diegovalverde/papiGB/(list of files, cad)

Other CAD files:
cad/papiGB.scad
