diegovalverde/papiGB/rtl/timers.v

`timescale 1ns / 1ps
`include "collaterals.v"
`include "z80_opcode_definitions.v"
`include "aDefinitions.v"
////////////////////////////////////////////////////////////////////////////////////
//
// pGB, yet another FPGA fully functional and super fun GB classic clone!
// Copyright (C) 2015-2016  Diego Valverde (diego.valverde.g@gmail.com)
//
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
////////////////////////////////////////////////////////////////////////////////////

`define TIMER_AFTER_RESET   0
`define TIMER_WAIT_FOR_TICK 1
`define TIMER_INC           2
`define TIMER_INC_BTAKEN    3
`define TIMER_INC_BTAKEN_NOT_EOF 4
`define TIMER_WAIT_EOF           5

`define INITIAL_STATE_INT   0
`define WAIT_FOR_INTERRUPT  1
`define INT_ACTIVATED       2
`define ENABLE_INT_OFFSET   3

`define INITIAL_STATE_TIMA  0
`define WAIT_FOR_TAC_2      1
`define TAC_2_ACTIVATED     2
`define WAIT_FOR_TAC_2_OFF  3


module timers
(
 input wire iClock,
 input wire iReset,
 input wire [7:0] iOpcode,
 input wire iEof,
 input wire iBranchTaken,
 input wire iInterrupt,

 input wire        iMcuWe,
 input wire [3:0]  iMcuRegSelect, //control register select comes from cpu
 input wire [7:0]  iMcuWriteData, //what does the cpu want to write


 output wire [7:0] oDiv,         //0xFF04
 output wire [7:0] oTima,        //0xFF05
 output wire [7:0] oModulo,      //0xFF06
 output wire [7:0] oTac,         //0xFF07




 output wire oInterrupt0x50

);


wire [7:0] wMcuRegWriteSelect;
assign wMcuRegWriteSelect = (1 << iMcuRegSelect);


////////////////////////////////////////////////
//
// Register 0xFF04:  Divider  Counts up at a fixed 16384Hz;
// reset to 0 whenever written to
//
////////////////////////////////////////////////

 UPCOUNTER_POSEDGE # (8) DIV
(
.Clock(  iClock  ),
.Reset(  iReset  ),
.Initial( 8'd211 ),
.Enable( wIncDiv ),
.Q(     oDiv     )
);


////////////////////////////////////////////////
//
// Register 0xFF05: Counter (Tima)  Counts up at the specified rate
// Triggers INT 0x50 when going 255->0
//
////////////////////////////////////////////////
wire      wIncTima;     //Set to indicate Tima is to be incremented by 1
assign    oInterrupt0x50 = ( oTima == 8'd255 && wIncTima ) ? 1'b1 : 1'b0;
wire [7:0] wTimaInitialvalue;
assign wTimaInitialvalue = (iReset) ? 8'b0 : oModulo ;


 UPCOUNTER_POSEDGE # (8) TIMA
(
.Clock(    iClock                   ),
.Reset(    iReset | oInterrupt0x50  ),
.Initial(  wTimaInitialvalue        ),
.Enable(   wIncTima                 ),
.Q(        oTima                    )
);


////////////////////////////////////////////////
//
// Register 0xFF06:  Modulo  When Tima overflows to 0,
// it's reset to start at Modulo
//
////////////////////////////////////////////////

reg [7:0] rModulo;
assign oModulo = rModulo;

////////////////////////////////////////////////
///
///  Register 0xFF07: Timer control (rTac)
//   Bits  Function  Details
//   0-1  Speed      00: 4096Hz
//                  01: 262144Hz
//                  10: 65536Hz
//                  11: 16384Hz
//   2    Running    1 to run timer, 0 to stop
//   3-7  Unused
///////////////////////////////////////////////
wire [5:0] wSpeed, wTimaFreq;


FFD_POSEDGE_SYNCRONOUS_RESET # ( 8 )FF_TAC
(
.Clock(           iClock              ),
.Reset(           iReset              ),
.Enable(iMcuWe & wMcuRegWriteSelect[7]),
.D(           iMcuWriteData           ),
.Q(               oTac                )
);

MUXFULLPARALELL_2SEL_GENERIC # ( 6 ) MUX_SPEED
 (
 .Sel( oTac[1:0] ),
 .I0(   6'd63    ), // 4096 Hz   = 262144 Hz / 64
 .I1(   6'd0     ), // 262144 Hz = 262144 Hz / 1
 .I2(   6'd3     ), // 65536 Hz  = 262144 Hz / 4
 .I3(   6'd15    ), // 16384 Hz  = 262144 Hz / 16
 .O(    wSpeed   )
 );

//Suma a una frecuencia de 262144 Hz
 UPCOUNTER_POSEDGE # (6) DIV_AUX
(
.Clock(                 iClock                     ),
.Reset(               iReset | wIncTima            ),
.Initial(                6'b0                      ),
.Enable( oTac[2] & (wIncDivAux | wIncDivAuxInHalt) ),
.Q(                   wTimaFreq                    )
);

assign wIncTima =  ((wTimaFreq == wSpeed) &
                   (wIncDivAux | wIncDivAuxInHalt)) ? 1'b1 : 1'b0;


wire wIsCb;
wire [1:0] wDivOverflow;
reg  rIsBranch;



    wire [47:0] wClockIncrementRow, wClockIncrementRowCB;
    wire [47:0] wClockIncrementRowBasic,wClockIncrementRowBranch,wClockIncrementRow_Pre, wClockIncrementRow_Pre_Pre;
    wire [2:0]  wClockIncrement;


    MUXFULLPARALELL_4SEL_GENERIC #(48) MUX_CLOCK_STEP_1
    (
        .Sel(iOpcode[7:4]),
    /*000*/    .I0( {3'd1, 3'd3, 3'd2, 3'd2, 3'd1, 3'd1, 3'd2, 3'd1, 3'd5, 3'd2, 3'd2, 3'd2, 3'd1, 3'd1, 3'd2, 3'd1}),
    /*016*/    .I1( {3'd1, 3'd3, 3'd2, 3'd2, 3'd1, 3'd1, 3'd2, 3'd1, 3'd3, 3'd2, 3'd2, 3'd2, 3'd1, 3'd1, 3'd2, 3'd1}),
    /*032*/    .I2( {3'd2, 3'd3, 3'd2, 3'd2, 3'd1, 3'd1, 3'd2, 3'd1, 3'd2, 3'd2, 3'd2, 3'd2, 3'd1, 3'd1, 3'd2, 3'd1}),
    /*048*/    .I3( {3'd2, 3'd3, 3'd2, 3'd2, 3'd3, 3'd3, 3'd3, 3'd1, 3'd2, 3'd2, 3'd2, 3'd2, 3'd1, 3'd1, 3'd2, 3'd1}),
    /*064*/    .I4( {3'd1, 3'd1, 3'd1, 3'd1, 3'd1, 3'd1, 3'd2, 3'd1, 3'd1, 3'd1, 3'd1, 3'd1, 3'd1, 3'd1, 3'd2, 3'd1}),
    /*080*/    .I5( {3'd1, 3'd1, 3'd1, 3'd1, 3'd1, 3'd1, 3'd2, 3'd1, 3'd1, 3'd1, 3'd1, 3'd1, 3'd1, 3'd1, 3'd2, 3'd1}),
    /*096*/    .I6( {3'd1, 3'd1, 3'd1, 3'd1, 3'd1, 3'd1, 3'd2, 3'd1, 3'd1, 3'd1, 3'd1, 3'd1, 3'd1, 3'd1, 3'd2, 3'd1}),
    /*112*/    .I7( {3'd2, 3'd2, 3'd2, 3'd2, 3'd2, 3'd2, 3'd1, 3'd2, 3'd1, 3'd1, 3'd1, 3'd1, 3'd1, 3'd1, 3'd2, 3'd1}),
    /*128*/    .I8( {3'd1, 3'd1, 3'd1, 3'd1, 3'd1, 3'd1, 3'd2, 3'd1, 3'd1, 3'd1, 3'd1, 3'd1, 3'd1, 3'd1, 3'd2, 3'd1}),
    /*144*/    .I9( {3'd1, 3'd1, 3'd1, 3'd1, 3'd1, 3'd1, 3'd2, 3'd1, 3'd1, 3'd1, 3'd1, 3'd1, 3'd1, 3'd1, 3'd2, 3'd1}),
    /*160*/    .I10({3'd1, 3'd1, 3'd1, 3'd1, 3'd1, 3'd1, 3'd2, 3'd1, 3'd1, 3'd1, 3'd1, 3'd1, 3'd1, 3'd1, 3'd2, 3'd1}),
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
        .I14({3'd2, 3'd2, 3'd2, 3'd2, 3'd2, 3'd2, 3'd4, 3'd2, 3'd2, 3'd2, 3'd2, 3'd2, 3'd2, 3'd2, 3'd4, 3'd2}),
        .I15({3'd2, 3'd2, 3'd2, 3'd2, 3'd2, 3'd2, 3'd4, 3'd2, 3'd2, 3'd2, 3'd2, 3'd2, 3'd2, 3'd2, 3'd4, 3'd2}),
        .O(wClockIncrementRowCB)

    );

MUXFULLPARALELL_4SEL_GENERIC #(48) MUX_CLOCK_STEP_1_BRANCHES
(
    .Sel(iOpcode[7:4]),
    .I0({3'd1, 3'd3, 3'd2, 3'd2, 3'd1, 3'd1, 3'd2, 3'd1, 3'd5, 3'd2, 3'd2, 3'd2, 3'd1, 3'd1, 3'd2, 3'd1}),
    .I1({3'd1, 3'd3, 3'd2, 3'd2, 3'd1, 3'd1, 3'd2, 3'd1, 3'd3, 3'd2, 3'd2, 3'd2, 3'd1, 3'd1, 3'd2, 3'd1}),
    .I2({3'd3, 3'd3, 3'd2, 3'd2, 3'd1, 3'd1, 3'd2, 3'd1, 3'd3, 3'd2, 3'd2, 3'd2, 3'd1, 3'd1, 3'd2, 3'd1}),
    .I3({3'd3, 3'd3, 3'd2, 3'd2, 3'd3, 3'd3, 3'd3, 3'd1, 3'd3, 3'd2, 3'd2, 3'd2, 3'd1, 3'd1, 3'd2, 3'd1}),
    .I4({3'd1, 3'd1, 3'd1, 3'd1, 3'd1, 3'd1, 3'd2, 3'd1, 3'd1, 3'd1, 3'd1, 3'd1, 3'd1, 3'd1, 3'd2, 3'd1}),
    .I5({3'd1, 3'd1, 3'd1, 3'd1, 3'd1, 3'd1, 3'd2, 3'd1, 3'd1, 3'd1, 3'd1, 3'd1, 3'd1, 3'd1, 3'd2, 3'd1}),
    .I6({3'd1, 3'd1, 3'd1, 3'd1, 3'd1, 3'd1, 3'd2, 3'd1, 3'd1, 3'd1, 3'd1, 3'd1, 3'd1, 3'd1, 3'd2, 3'd1}),
    .I7({3'd2, 3'd2, 3'd2, 3'd2, 3'd2, 3'd2, 3'd1, 3'd2, 3'd1, 3'd1, 3'd1, 3'd1, 3'd1, 3'd1, 3'd2, 3'd1}),
    .I8({3'd1, 3'd1, 3'd1, 3'd1, 3'd1, 3'd1, 3'd2, 3'd1, 3'd1, 3'd1, 3'd1, 3'd1, 3'd1, 3'd1, 3'd2, 3'd1}),
    .I9({3'd1, 3'd1, 3'd1, 3'd1, 3'd1, 3'd1, 3'd2, 3'd1, 3'd1, 3'd1, 3'd1, 3'd1, 3'd1, 3'd1, 3'd2, 3'd1}),
    .I10({3'd1, 3'd1, 3'd1, 3'd1, 3'd1, 3'd1, 3'd2, 3'd1, 3'd1, 3'd1, 3'd1, 3'd1, 3'd1, 3'd1, 3'd2, 3'd1}),
    .I11({3'd1, 3'd1, 3'd1, 3'd1, 3'd1, 3'd1, 3'd2, 3'd1, 3'd1, 3'd1, 3'd1, 3'd1, 3'd1, 3'd1, 3'd2, 3'd1}),
    .I12({3'd5, 3'd3, 3'd4, 3'd4, 3'd6, 3'd4, 3'd2, 3'd4, 3'd5, 3'd4, 3'd4, 3'd0, 3'd6, 3'd6, 3'd2, 3'd4}),
    .I13({3'd5, 3'd3, 3'd4, 3'd0, 3'd6, 3'd4, 3'd2, 3'd4, 3'd5, 3'd4, 3'd4, 3'd0, 3'd6, 3'd0, 3'd2, 3'd4}),
    .I14({3'd3, 3'd3, 3'd2, 3'd0, 3'd0, 3'd4, 3'd2, 3'd4, 3'd4, 3'd1, 3'd4, 3'd0, 3'd0, 3'd0, 3'd2, 3'd4}),
    .I15({3'd3, 3'd3, 3'd2, 3'd1, 3'd0, 3'd4, 3'd2, 3'd4, 3'd3, 3'd2, 3'd4, 3'd1, 3'd0, 3'd0, 3'd2, 3'd4}),
    .O(wClockIncrementRowBranch)

);


//---------------------------------------------------------------
// Time offset when an interrupt occurs
reg rInterruptOffset;
reg [1:0] rCurrentState_Int, rNextState_Int;

always @(posedge iClock)
begin
    if (iReset != 1)
        rCurrentState_Int <= rNextState_Int;
    else
        rCurrentState_Int <= `INITIAL_STATE_INT;
end
//------------------------------------------------

always @( * )
begin
    case (rCurrentState_Int)
    //--------------------------
    `INITIAL_STATE_INT:
    begin
        rInterruptOffset  = 1'b0;

        rNextState_Int    = `WAIT_FOR_INTERRUPT;
    end
    //-------------------------------
    `WAIT_FOR_INTERRUPT:
    begin
        rInterruptOffset  = 1'b0;

        if (iInterrupt)
            rNextState_Int = `INT_ACTIVATED;
        else
            rNextState_Int = `WAIT_FOR_INTERRUPT;
    end
    //--------------------------------
    `INT_ACTIVATED:
    begin
        rInterruptOffset = 1'b0;

        if (~iInterrupt)
            rNextState_Int = `ENABLE_INT_OFFSET;
        else
            rNextState_Int = `INT_ACTIVATED;
    end
    //--------------------------------
    `ENABLE_INT_OFFSET:
    begin
        rInterruptOffset = 1'b1;

        if (rIncTimer | wIncDivInHalt)
            rNextState_Int = `WAIT_FOR_INTERRUPT;
        else
            rNextState_Int = `ENABLE_INT_OFFSET;
    end
    //---------------------------------
    default:
    begin
        rInterruptOffset = 1'b0;

        rNextState_Int = `WAIT_FOR_INTERRUPT;
    end
    //--------------------------------------------------
    endcase
end //always


//---------------------------------------------------------------
// Reset wDivAux when oTac[2] gets up
reg rResetDivAux;
reg [1:0] rCurrentState_TIMA, rNextState_TIMA;

always @(posedge iClock)
begin
    if (iReset != 1)
        rCurrentState_TIMA <= rNextState_TIMA;
    else
        rCurrentState_TIMA <= `INITIAL_STATE_TIMA;
end
//------------------------------------------------

always @( * )
begin
    case (rCurrentState_TIMA)
    //--------------------------
    `INITIAL_STATE_TIMA:
    begin
        rResetDivAux    = 1'b0;

        rNextState_TIMA = `WAIT_FOR_TAC_2;
    end
    //-------------------------------
    `WAIT_FOR_TAC_2:
    begin
        rResetDivAux    = 1'b0;

        if (oTac[2])
            rNextState_TIMA = `TAC_2_ACTIVATED;
        else
            rNextState_TIMA = `WAIT_FOR_TAC_2;
    end
    //--------------------------------
    `TAC_2_ACTIVATED:
    begin
        rResetDivAux    = 1'b1;

        rNextState_TIMA = `WAIT_FOR_TAC_2_OFF;
    end
    //--------------------------------
    `WAIT_FOR_TAC_2_OFF:
    begin
        rResetDivAux    = 1'b0;

        if (~oTac[2])
            rNextState_TIMA = `WAIT_FOR_TAC_2;
        else
            rNextState_Int = `WAIT_FOR_TAC_2_OFF;
    end
    //---------------------------------
    default:
    begin
        rResetDivAux    = 1'b0;

        rNextState_TIMA = `WAIT_FOR_TAC_2;
    end
    //--------------------------------------------------
    endcase
end //always


wire  [7:0] wDelta;
assign wDelta = (rInterruptOffset) ? wClockIncrement + 8'd5 : wClockIncrement;

wire [7:0] wDiv,wTima;
assign wTima = oTima;

wire [3:0] wDivAux;
wire [1:0] wDivAuxOF;
reg rTimerSel, rIncTimer;

assign {wDivOverflow,wDiv} = (rMTime << 2);
assign {wDivAuxOF,wDivAux} = (rResetDivAux) ? 6'b0 : (rMTime[3:0] << 2);

  reg  [7:0]  rMTime;
  reg         rIncrementBTime;

   always @ (posedge iClock)
   begin
      if (iReset)
      begin
        rMTime    = 8'b0;
      end
      else
      begin
        if (rIncTimer | wIncDivInHalt)
          {rIncrementBTime,rMTime} = rMTime + {4'b0,wDelta[3:0]};
      end
   end //always


   //--------------------------------------------------------
   // Current State Logic //
   reg [7:0]    rCurrentState,rNextState;

   always @(posedge iClock )
   begin
        if( iReset!=1 )
           rCurrentState <= rNextState;
      else
           rCurrentState <= `TIMER_AFTER_RESET;
   end
   //--------------------------------------------------------

   always @( * )
    begin
     case (rCurrentState)
     //----------------------------------------
     `TIMER_AFTER_RESET:
     begin
       rTimerSel    = 1'b0;
       rIncTimer    = 1'b0;

       rNextState = `TIMER_WAIT_FOR_TICK;
     end
     //----------------------------------------
     `TIMER_WAIT_FOR_TICK:
     begin
     rTimerSel    = 1'b0;
     rIncTimer    = 1'b0;

      if ( iInterrupt )
          rNextState = `TIMER_INC_BTAKEN;
      else if (rIsBranch & iBranchTaken & iEof)
          rNextState = `TIMER_INC_BTAKEN;
      else if (rIsBranch & iBranchTaken & ~iEof)
          rNextState = `TIMER_INC_BTAKEN_NOT_EOF;
      else if (iEof)
          rNextState = `TIMER_INC;
      else
          rNextState = `TIMER_WAIT_FOR_TICK;
     end
     //----------------------------------------
     `TIMER_INC:
     begin
        rTimerSel   = 1'b0;
        rIncTimer   = 1'b1;

       rNextState = `TIMER_WAIT_FOR_TICK;
     end
     //----------------------------------------
     `TIMER_INC_BTAKEN:
     begin
        rTimerSel   = 1'b1;
        rIncTimer   = 1'b1;

      if (~iInterrupt)
        rNextState = `TIMER_WAIT_FOR_TICK;
      else
        rNextState = `TIMER_WAIT_EOF;
     end
     //----------------------------------------
   `TIMER_INC_BTAKEN_NOT_EOF:
     begin
        rTimerSel   = 1'b1;
        rIncTimer   = 1'b1;
        if (iEof)
          rNextState = `TIMER_WAIT_FOR_TICK;
        else
          rNextState = `TIMER_WAIT_EOF;

     end
     //----------------------------------------
     `TIMER_WAIT_EOF:
     begin
        rTimerSel   = 1'b1;
        rIncTimer   = 1'b0;

        if (iEof)
            rNextState = `TIMER_WAIT_FOR_TICK;
        else
            rNextState = `TIMER_WAIT_EOF;
     end
     //----------------------------------------
     default:
     begin
         rTimerSel    = 1'b0;
         rIncTimer    = 1'b0;

         rNextState = `TIMER_AFTER_RESET;
     end
     //----------------------------------------
     endcase
  end //always


//--------------------------------------------------------
// Clock Increment Logic for wDIV overflow and wDivAux overflow//
reg  [8:0] rDivNextToOverflow;
reg  [5:0] rDivAuxNextToOF;
wire [5:0] wPreviousValue;
wire [8:0] wDivAuxCounter;
wire [4:0] wDivCounter;
wire wIncDiv, wIncDivAux, wDivAuxChanged, wIncDivInHalt, wIncDivAuxInHalt;


assign wIncDiv          = rDivNextToOverflow[8] & (rIncTimer | wIncDivInHalt);
assign wDivAuxChanged   = (wPreviousValue == rDivAuxNextToOF) ? 1'b0 : 1'b1;
assign wIncDivAux = wDivAuxChanged & (rDivAuxNextToOF[5] | rDivAuxNextToOF[4]);
assign wIncDivInHalt    = (wDivCounter == 5'd23) ? 1'b1 : 1'b0;
assign wIncDivAuxInHalt = (wDivAuxCounter == 9'd380) ? 1'b1 : 1'b0;


FFD_POSEDGE_SYNCRONOUS_RESET # ( 6 )FF_DIV_AUX
(
.Clock(   iClock    ),
.Reset(   iReset    ),
.Enable( rIncTimer  ),
.D( rDivAuxNextToOF ),
.Q( wPreviousValue  )
);

UPCOUNTER_POSEDGE # (9) DIV_AUX_IN_HALT
(
.Clock(         iClock            ),
.Reset( iReset | wIncDivAuxInHalt ),
.Initial(         9'b0            ),
.Enable(    iOpcode == 8'h76      ),
.Q(       wDivAuxCounter          )
);

UPCOUNTER_POSEDGE # (5) DIV_IN_HALT
(
.Clock(        iClock          ),
.Reset( iReset | wIncDivInHalt ),
.Initial(        5'b0          ),
.Enable(   iOpcode == 8'h76    ),
.Q(          wDivCounter       )
);


//-----------------------------------------------------------
always @(negedge iClock)
begin
    if (rIncTimer | wIncDivInHalt)
    begin
        rDivNextToOverflow = wDiv + (wClockIncrement << 2);
        rDivAuxNextToOF    = wDivAux + (wClockIncrement << 2);
    end
end


endmodule
