diegovalverde/papiGB/rtl/mmu.v

`timescale 1ns / 1ps
////////////////////////////////////////////////////////////////////////////////////
//
// pGB, yet another FPGA fully functional and super fun GB classic clone!
// Copyright (C) 2015-2016  Diego Valverde (diego.valverde.g@gmail.com)
//
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
////////////////////////////////////////////////////////////////////////////////////
module mmu
(
	input wire iClock,
	input wire iReset,

	//CPU
	input wire        iCpuReadRequest,
	input wire [15:0] iCpuAddr,
	input wire        iCpuWe,
	input wire [7:0]  iCpuData,
	output wire [7:0] oCpuData,

	//GPU
	output wire [7:0] oGpuVmemReadData,
	input wire        iGpuReadRequest,
	input wire [15:0] iGpuAddr,

	//Special Function Registers in other modules
	output wire [3:0] oRegSelect,
	output wire [2:0] oRegWe,
	output wire [7:0] oRegData,

	//Interrupts
	input wire [7:0] iInterruptRequest,

	//IO Registers
	input wire [7:0]  iGPU_LCDC,
	input wire [7:0]  iGPU_STAT,
	input wire [7:0]  iGPU_SCY,
	input wire [7:0]  iGPU_SCX,
	input wire [7:0]  iGPU_LY,
	input wire [7:0]  iGPU_LYC,
	input wire [7:0]  iGPU_DMA,
	input wire [7:0]  iGPU_BGP,
	input wire [7:0]  iGPU_OBP0,
	input wire [7:0]  iGPU_OBP1,
	input wire [7:0]  iGPU_WY,
	input wire [7:0]  iGPU_WX,

	input wire [7:0]  iInterruptEnable,
	input wire [7:0]  iInterruptFlag,

	//IO
	input wire [7:0] iButtonRegister


);
	wire [7:0] wBiosData, wZeroPageDataOut, wWorkRamDataOut, wZIOData, wIORegisters,wLCDRegisters,wSoundRegisters_Group0,wSoundRegisters_Group1;
	wire [7:0] wSoundRegisters_WavePattern, wJoyPadAndTimers;
	wire [15:0] wAddr, wVmemReadAddr;
	wire wInBios, wInCartridgeBank0, wWeZeroPage, wWeVRam, wCPU_GPU_Sel, wWeWorkRam;
	wire [3:0] wMemSel_H, wMemSel_L;
	wire [7:0] wReadCartridgeBank0, wReadVmem, wReadData_L, wOAMData;


	//Choose who has Memory access at this point in time: GPU or CPU
	//Simply check MSb from STAT mode. Also check to see if LCD is ON
	assign wCPU_GPU_Sel = ( iGPU_LCDC[7] & iGPU_STAT[1]  ) ? 1'b1 : 1'b0 ;
	assign wAddr =  iCpuAddr;
	assign wVmemReadAddr = ( wCPU_GPU_Sel ) ? iGpuAddr[12:0] : iCpuAddr[12:0];
	assign oRegData = iCpuData;
  assign oGpuVmemReadData = (iGpuAddr[15:8] == 8'hfe) ?  wOAMData : wReadVmem;



  ///////////////////////////////////////////////////////////////
	//
	// The MMU is essentially a cascade of Multiplexers
	// MUX_MEMREAD_H is the final Multiplexer to output the
	// oCpuData port
  //
	// Address Range: 0000 - FFFF
	//
	///////////////////////////////////////////////////////////////

	MUXFULLPARALELL_4SEL_GENERIC # (8) MUX_MEMREAD_H
	(
		.Sel( wAddr[15:12] ),
		//0000 - 7FFF : ROM Bank 0
		.I0(wReadCartridgeBank0), .I1(wReadCartridgeBank0),
		.I2(wReadCartridgeBank0), .I3(wReadCartridgeBank0),
		.I4(wReadCartridgeBank0), .I5(wReadCartridgeBank0),
		.I6(wReadCartridgeBank0), .I7(wReadCartridgeBank0),

		//8000 - 9FFF: VIDEO RAM
		.I8(wReadVmem), .I9(wReadVmem),

		//A000 - BFFF: External RAM
		.I10(8'b0), .I11(8'b0),      //A000 - BFFF

		//C000 - EFFF:  Work RAM and Echo
		.I12( wWorkRamDataOut     ), //C000 - CFFF
		.I13( wWorkRamDataOut     ), //D000 - DFFF
		.I14(wReadCartridgeBank0  ), //E000 - EFFF

		//F000 - FFFF: Extended Regions
		.I15( wReadData_L ),

		.O( oCpuData )
	);

	///////////////////////////////////////////////////////////////
	//
	// MUX: MUX_MEMREAD_L Contains extended regions
	//
	// Address Range: F000 - FFFF
	//
	///////////////////////////////////////////////////////////////


	MUXFULLPARALELL_4SEL_GENERIC # (8) MUX_MEMREAD_L
	(
		.Sel( wAddr[11:8] ),
		//ECHO
		.I0(8'b0), .I1(8'b0),   //F000 - F1FF
		.I2(8'b0), .I3(8'b0),   //F200 - F3FF
		.I4(8'b0), .I5(8'b0),   //F400 - F5FF
		.I6(8'b0), .I7(8'b0),   //F600 - F7FF
		.I8(8'b0), .I9(8'b0),   //F800 - F9FF
		.I10(8'b0), .I11(8'b0), //FA00 - FBFF
		.I12(8'b0), .I13(8'b0), //FC00 - FDFF
		//OAM.
		.I14( wOAMData),		    //FE00 - FEFF

		//Zeropage RAM, I/O, interrupts
		.I15( wZIOData ), //FF00 - FFFF

		.O( wReadData_L )
	);


	///////////////////////////////////////////////////////////////
	//
	// MUX: ZEROPAGE, INTERRUPTS, IO DATA
	//
	// Address Range: FF00 - FFFF
	//
	///////////////////////////////////////////////////////////////
	wire [7:0] wHighMemory;

	MUXFULLPARALELL_2SEL_GENERIC # (8) MUX_MEMREAD_IO_ZERPAGE_INTERRUPTS
	(
		.Sel( wAddr[7:6]),
		.I0( wIORegisters     ),    //FF00-FF3F
		.I1( wIORegisters     ),    //FF40-FF7F
		.I2( wZeroPageDataOut ),	  //FF80-FFBF
		.I3( wHighMemory      ),	  //FFC0-FFFF
		.O(  wZIOData )

	);

  assign wHighMemory =
	( wAddr == 16'hffff ) ? iInterruptEnable : wZeroPageDataOut;

	///////////////////////////////////////////////////////////////
	//
	// MUX: INTERRUPTS, IO DATA
	//
	// Address Range: FF00 - FF7F
	//
	///////////////////////////////////////////////////////////////
	MUXFULLPARALELL_3SEL_GENERIC # (8) MUX_MEMREAD_IO_REGISTERS
	(
		.Sel( wAddr[6:4]),
		.I0( wJoyPadAndTimers            ),   //FF00-FF0     wAddr[6:4] = 000
		.I1( wSoundRegisters_Group0      ),   //1F-F    wAddr[6:4] = 001
		.I2( wSoundRegisters_Group1      ),   //2F-20   wAddr[6:4] = 010
		.I3( wSoundRegisters_WavePattern ),   //3F-30   wAddr[6:4] = 011
		.I4( wLCDRegisters               ),   //4F-40   wAddr[6:4] = 100
		.I5( 8'b0                        ),
		.I6( 8'b0                        ),
		.I7( 8'b0                        ),
		.O( wIORegisters )
	);



////////////////////////////////////////////////
//
// 8000-9FFF   8KB Video RAM (VRAM) (switchable bank 0-1 in CGB Mode)
//
////////////////////////////////////////////////
RAM_SINGLE_READ_PORT # ( .DATA_WIDTH(8), .ADDR_WIDTH(13), .MEM_SIZE(8192) ) VMEM
(
 .Clock( iClock ),
 .iWriteEnable(  wWeVRam              ),
 .iReadAddress0( wVmemReadAddr[12:0]  ),
 .iWriteAddress( wAddr[12:0]          ),
 .iDataIn(       iCpuData             ),
 .oDataOut0(     wReadVmem            )
);

////////////////////////////////////////////////
//
// Sprite OAM RAM 0xFE00 - 0xFE9F
//
////////////////////////////////////////////////
RAM_SINGLE_READ_PORT # ( .DATA_WIDTH(8), .ADDR_WIDTH(8), .MEM_SIZE(160) ) OAM
(
 .Clock( iClock ),
 .iWriteEnable(  wWeVRam              ),		//Since this is DMA, this has to change
 .iReadAddress0( wVmemReadAddr[7:0]   ),
 .iWriteAddress( wAddr[7:0]           ),
 .iDataIn(       iCpuData             ),
 .oDataOut0(     wOAMData             )
);

////////////////////////////////////////////////
//
// ZERO PAGE
//
// A high-speed area of 128 bytes of RAM.
// Will use FPGA internal mem since most of the interaction between
// the program and the GameBoy hardware occurs through use of this page of memory.
//
////////////////////////////////////////////////
RAM_SINGLE_READ_PORT # ( .DATA_WIDTH(8), .ADDR_WIDTH(7), .MEM_SIZE(128) ) ZERO_PAGE
(
 .Clock( iClock ),
 .iWriteEnable( wWeZeroPage   ),
 .iReadAddress0( wAddr[6:0]   ),
 .iWriteAddress( wAddr[6:0]   ),
 .iDataIn(       iCpuData        ),
 .oDataOut0( wZeroPageDataOut )
);


////////////////////////////////////////////////
//
// Register 0xFF50: Unmaps BIOS ROM
//
////////////////////////////////////////////////

wire wWe0x50Reg;
wire [7:0] wRegMapBootStapRom;
assign wWe0x50Reg = (iCpuWe && iCpuAddr == 4'hff50) ? 1'b1: 1'b0;
FFD_POSEDGE_SYNCRONOUS_RESET # ( 8 )FF_0x50(
	iClock, iReset  , wWe0x50Reg, iCpuData, wRegMapBootStapRom );



RAM_SINGLE_READ_PORT # ( .DATA_WIDTH(8), .ADDR_WIDTH(13), .MEM_SIZE(8191) ) WORK_RAM
(
 .Clock( iClock ),
 .iWriteEnable( wWeWorkRam   ),
 .iReadAddress0( wAddr[12:0]   ),
 .iWriteAddress( wAddr[12:0]   ),
 .iDataIn(       iCpuData        ),
 .oDataOut0( wWorkRamDataOut )
);

//both addresses FFFF and FF0F yield to interrupts, this is why we
//remap FFFF to 0000
assign oRegSelect = ( &iCpuAddr ) ? 4'b0 : wAddr[3:0];

///  READ .///

`ifdef LY_OVERRIDE_PATH
wire [7:0] wGPU_LY;

ly_override lyover((iCpuReadRequest == 1'b1 && wAddr == 16'hff44) ,wGPU_LY);

`endif
MUXFULLPARALELL_4SEL_GENERIC # (8) MUX_MEMREAD_LCD_REGISTERS
(
	.Sel( wAddr[3:0]),
	.I0( iGPU_LCDC            ),
	.I1( iGPU_STAT            ),
	.I2( iGPU_SCY             ),
	.I3( iGPU_SCX             ),
`ifdef LY_OVERRIDE_PATH
	.I4( wGPU_LY              ),
`else
	.I4( iGPU_LY              ),
`endif
	.I5( iGPU_LYC             ),
	.I6( iGPU_DMA             ),
	.I7( iGPU_BGP             ),
	.I8( iGPU_OBP0            ),
	.I9( iGPU_OBP1            ),
	.I10( iGPU_WY             ),
	.I11( iGPU_WX             ),
	.I12( 8'b0                ),
	.I13( 8'b0                ),
	.I14( 8'b0                ),
	.I15( 8'b0                ),
	.O( wLCDRegisters )
);





MUXFULLPARALELL_4SEL_GENERIC # (8) MUX_MEMREAD_IO_BUTTON
(
	.Sel( wAddr[3:0]),
	.I0( iButtonRegister            ),   //FF00 P1 register
	.I1(8'b0  ), //FF01
	.I2(8'b0  ), //FF02
	.I3(8'b0  ), //FF03
	.I4(8'b0  ), //FF04
	.I5(8'b0  ), //FF05
	.I6(8'b0  ), //FF06
	.I7(8'b0  ), //FF07
	.I8(8'b0  ), //FF08
	.I9(8'b0  ), //FF09
	.I10(8'b0  ), //FF0A
 	.I11(8'b0  ), //FF0B
	.I12(8'b0  ), //FF0C
	.I13(8'b0  ), //FF0D
	.I14(8'b0  ), //FF0E
	.I15(iInterruptFlag  ), //FF0F
	.O( wJoyPadAndTimers  )
);




	bios BIOS
	(
		.iClock( iClock ),
		.iAddr( iCpuAddr[7:0] ),
		.oData( wBiosData  )
	);

//ZeroPage FF80 - FFFF
assign wWeZeroPage = ( iCpuWe && wAddr[15:12] == 4'hf && wAddr[11:8] == 4'hf && (wAddr[7:6] == 2'h2 || wAddr[7:6] == 2'h3) ) ? 1'b1 : 1'b0 ;
assign wWeVRam     = ( iCpuWe && (wAddr[15:12] == 4'h8 || wAddr[15:12] == 4'h9 ) ) ? 1'b1 : 1'b0;
assign oRegWe[0]  = ( iCpuWe && wAddr[15:4] == 12'hff4 ) ? 1'b1 : 1'b0;  //GPU
assign oRegWe[1]  = ( iCpuWe && wAddr[15:4] == 12'hff0 ) ? 1'b1 : 1'b0;  //TIMER
assign oRegWe[2]  = ( iCpuWe & (&wAddr | wAddr == 16'hff0f) ) ? 1'b1 : 1'b0;  //INTERRUPT
//Working RAM C000 - DFFF
assign wWeWorkRam  = ( iCpuWe && wAddr[15:13] == 3'h6 ) ? 1'b1 : 1'b0;


assign wInBios           = (wAddr & 16'hff00) ? 1'b0 : 1'b1; //0x000 - 0x0100, also remember to use 0xff50, this unmaps bios ROM
assign wInCartridgeBank0 = (wAddr & 16'hc000) ? 1'b0 : 1'b1; //0x100 - 0x3fff

`ifndef REAL_CARTRIDGE_DATA
wire [7:0] wCartridgeDataBank0;

assign wReadCartridgeBank0 = (wInBios & ~wRegMapBootStapRom[0] ) ? wBiosData : wCartridgeDataBank0;



dummy_cartridge DummyCartridgeBank0
(
  .iAddr( wAddr ),
	.oData( wCartridgeDataBank0 )
);

`endif
endmodule
`ifndef REAL_CARTRIDGE_DATA

`ifdef CARTRIGDE_DUMP_PATH
module dummy_cartridge
(
  input wire [15:0] iAddr,
	output reg [7:0] oData
);

reg [7:0] mem[65534:0];

always @ (iAddr)
begin
	 #(2*`CLOCK_CYCLE) oData = mem[iAddr];
end

initial
begin
	$readmemh(
		`CARTRIGDE_DUMP_PATH, mem);

end

endmodule

`else
module dummy_cartridge
(
  input wire [15:0] iAddr,
	output reg [7:0] oData
);

always @ ( iAddr )
begin
	case ( iAddr )
	//Add dummy game cartrige header
	16'h100: oData = 8'h00;
	16'h101: oData = 8'hc3;
	16'h102: oData = 8'h50;
	16'h103: oData = 8'h01;
	16'h104: oData = 8'hce; //Start of LOGO
	16'h105: oData = 8'hed;
	16'h106: oData = 8'h66;
	16'h107: oData = 8'h66;
	16'h108: oData = 8'hcc;
	16'h109: oData = 8'h0d;
	16'h10a: oData = 8'h00;
	16'h10b: oData = 8'h0b;
	16'h10c: oData = 8'h03;
	16'h10d: oData = 8'h73;
	16'h10e: oData = 8'h00;
	16'h10f: oData = 8'h83;

	16'h110: oData = 8'h00;
	16'h111: oData = 8'h0c;
	16'h112: oData = 8'h00;
	16'h113: oData = 8'h0d;
	16'h114: oData = 8'h00;
	16'h115: oData = 8'h08;
	16'h116: oData = 8'h11;
	16'h117: oData = 8'h1f;
	16'h118: oData = 8'h88;
	16'h119: oData = 8'h89;
	16'h11A: oData = 8'h00;
	16'h11B: oData = 8'h0E;
	16'h11C: oData = 8'hDC;
	16'h11D: oData = 8'hCC;
	16'h11E: oData = 8'h6E;
	16'h11F: oData = 8'hE6;

	16'h120: oData = 8'hdd;
	16'h121: oData = 8'hdd;
	16'h122: oData = 8'hd9;
	16'h123: oData = 8'h99;
	16'h124: oData = 8'hbb;
	16'h125: oData = 8'hbb;
	16'h126: oData = 8'h67;
	16'h127: oData = 8'h63;
	16'h128: oData = 8'h6e;
	16'h129: oData = 8'h0e;
	16'h12A: oData = 8'hec;
	16'h12B: oData = 8'hcc;
	16'h12C: oData = 8'hdd;
	16'h12D: oData = 8'hdc;
	16'h12E: oData = 8'h99;
	16'h12F: oData = 8'h9f;

	16'h130: oData = 8'hbb;
	16'h131: oData = 8'hb9;
	16'h132: oData = 8'h33;
	16'h133: oData = 8'h3e;
	16'h134: oData = 8'h54;
	16'h135: oData = 8'h45;
	16'h136: oData = 8'h54;
	16'h137: oData = 8'h52;

  default: oData = 8'h0;
	endcase
end//always


endmodule


`endif //CARTRIGDE_DUMP_PATH

`endif //REAL_CARTRIDGE_DATA


`ifdef LY_OVERRIDE_PATH
module ly_override
(
	input wire iEnable,
	output reg [7:0] oData
);

reg [7:0] mem[65534:0];
reg [31:0] count;



always @ (posedge iEnable)
begin
//	 $display("Reading mem[%d] = %h",count, mem[count]);
	 #(2*`CLOCK_CYCLE) oData = mem[count];
	 count = count + 1;

end

initial
begin
  count = 0;
	$readmemh(
		`LY_OVERRIDE_PATH, mem);

end

endmodule
`endif
