diegovalverde/papiGB/(commit log)

2015-12-19 fix: dev: fixed JNRZ loop exit condition
    [dzcpu_ucode_lut.v, z80_opcode_definitions.v]
2015-12-20 fix: dev: fixed missing sma -> pc for LDHLmr_a
    [dzcpu_ucode_lut.v]
2015-12-21 chg: dev: Fixed MMU read/write logic a little. Note that most of this logic is to be replace by actual FLASH/SRAM interfaces
    [mmu.v, tb_simple_dzcpu.v]
2015-12-22 fix: dev: Fixed missing uop srx8
    [dzcpu.v]
2015-12-22 fix: usr: now uops do not update flags by default
    [dzcpu.v, dzcpu_ucode_lut.v, z80_opcode_definitions.v]
2015-12-22 fix: usr: fixing uOp EOF conditions
    [dzcpu.v]
2015-12-22 fix: dev: Fixed bytes in sample cartridge header
    [tb_simple_dzcpu.v]
2015-12-23 chg: dev: Fixed tb to create VMEM dump file to compare againts reference ASCII dump
    [tb_simple_dzcpu.v]
2015-12-28 fix: dev: fixed bug in LDADEm
    [dzcpu.v, dzcpu_ucode_lut.v, tb_simple_dzcpu.v, z80_opcode_definitions.v]
2015-12-28 fix: dev: fixed incorrect (r) icon at address 8190
    [bios.v]
2015-12-28 fix: dev: Fixed missing incpc uop
    [dzcpu_ucode_lut.v]
2015-12-30 fix: dev: Fixed size of sel input in MUX
    [collaterals.v]
2015-12-30 fix: dev: Fixing warnings for dangling MUX inputs
    [dzcpu.v]
2016-01-03 chg: dev: Added oMcuReadRequest so in the future we do not always want to do SRAM read requests, for power efficiency and latency
2016-01-03 fix: dev: fixed incorrect MUX sel size
    [collaterals.v]
2016-01-04 fix: dev: Only VMEM area is Multiplexed between GPU and CPU
    [mmu.v]
2016-01-04 fix: usr: Fixed sub16 not correctly intepreting RHS operand as positive
    [dzcpu.v]
2016-01-05 fix: dev: Fixing some Xilinx warnings
    [dzcpu.v, gpu.v, pGB.v]
2016-01-05 fix: dev: temporary assigns to humor the synthesis tool
    [gpu.v]
2016-01-06 chg: dev: changing gpu macros to avoid name clashes
    [gpu.v, gpu_definitions.v, gpu_ucode_rom.v]
2016-01-06 fix: dev: Fixed incorrect VRAM read data signal from MMU to GPU
    [mmu.v, pGB.v]
2016-01-10 fix: dev: Fixed CPU access to GPU registers
    [gpu.v]
2016-01-12 chg: dev: Added wires to connect gpu frame signals, also changed GPU code to generate frame buffer
2016-01-12 chg: dev: modified testbench to generate more than 1 frame
2016-01-16 chg: dev: Adding folder to generate PPM frames
2016-01-16 fix: dev: Fixed wrong SCY calculation for animations
    [gpu.v, gpu_definitions.v, gpu_ucode_rom.v]
2016-01-17 fix: dev: Changed FB memory size to 8192
    [tb_simple_dzcpu.v]
2016-01-19 fix: dev: Added default instructions
    [bios.v]
2016-01-19 fix: dev: Fixed inferred latch
    [dzcpu.v]
2016-01-30 fix: dev: Fixed incorrect port direction
    [VgaController.v]
2016-02-09 chg: dev: Added SKIP_BIOS flag
    [dzcpu.v]
2016-02-09 fix: dev: Fixed timming in JPnn
    [dzcpu_ucode_lut.v]
2016-02-18 fix: dev: fixed CALLnn to support 16 bit jumps
    [dzcpu.v, dzcpu_ucode_lut.v, tb_simple_dzcpu.v, z80_opcode_definitions.v]
2016-03-03 new: usr: Added pin location files @wip
2016-03-15 new: dev: Created OpenScad file for 3D printing @wip
    This file has Marco's cool latest mods
    [papiGB.scad]
2016-03-21 chg: dev: bug found register for backgroud palette in TB uuut.GPU.FFS_BGP.Q defined as 0xE4 by nintendo is being badly read by gpu, colors are inverted, register value set to 0x27 as a soft patch.
    [tb_simple_dzcpu.v]
2016-03-22 fix: dev: Fixed case for negative tile idx and idx greater than 128
    [gpu.v, tb_simple_dzcpu.v]
2016-03-22 chg: dev: added new uUop fixed name of flip flop for sprite palette 1 FFX to FFS
    [gpu.v, gpu_definitions.v, gpu_ucode_rom.v, tb_simple_dzcpu.v]
2016-03-22 chg: dev: fixed some warnings
    [VgaController.v, gpu.v, gpu_definitions.v, gpu_ucode_rom.v]
2016-03-22 chg: dev: fixed mored warnings regarding wiring sizes
    [gpu.v]
2016-03-22 chg: dev: add support cpu interruptions @wip
2016-03-24 chg: usr: Updated instructions to install a Gameboy Assembler
2016-03-24 new: dev: Added simple assembly example
2016-03-24 fix: dev: Fixed address width for OAM
    [mmu.v, tb_simple_dzcpu.v]
2016-03-24 fix: dev: INCr_b now update flags
    [dzcpu_ucode_lut.v]
2016-03-25 fix: dev: INCr_d now updates flags
    [dzcpu_ucode_lut.v]
2016-03-25 fix: dev: Added changes that were accidentally lost in previous pull request
    [tb_simple_dzcpu.v]
2016-03-25 chg: dev: formula for isSpriteinCurrentTile was wrong, fixed it, it should be working now
    [gpu.v]
2016-03-25 fix: dev: INCr_e now updates flags
    [dzcpu_ucode_lut.v]
2016-03-25 fix: dev: INCr_a now updates flags
    [dzcpu_ucode_lut.v]
2016-03-25 fix: dev: INCr_l now updates flags
    [dzcpu_ucode_lut.v]
2016-03-25 fix: dev: INCr_h now updates flags
    [dzcpu_ucode_lut.v]
2016-03-25 fix: dev: INCr_c now updates flags
    [dzcpu_ucode_lut.v]
2016-03-26 fix: dev: Type error in dzpu_ucode_lut.v line 107
    [dzcpu_ucode_lut.v]
2016-03-27 fix: dev: fixed missing gnull and commented out flops
    [gpu.v, gpu_ucode_rom.v]
2016-03-27 fix: error in sprite muxes selector
    [gpu.v]
2016-03-27 fix: dev: Fixed sprite tile intersection test
    [gpu.v, gpu_ucode_rom.v, tb_simple_dzcpu.v]
2016-03-27 fix: dev: fixed sprite transparency, palleta and intersection test
    [gpu.v, gpu_ucode_rom.v]
2016-03-30 fix: dev: Converting tabs to spaces
    [dzcpu.v]
2016-04-01 chg: dev: Added CPU code for interrupt handling @wip
2016-04-01 fix: dev: Fixed zero flag, implemented LDDEmA
    [dzcpu.v, dzcpu_ucode_lut.v, tb_simple_dzcpu.v, z80_opcode_definitions.v]
2016-04-02 fix: dev: Fixed RET instruction to support 16bit addresses
    [dzcpu_ucode_lut.v, tb_simple_dzcpu.v]
2016-04-05 fix: dev: Fixed missing SP increment for RET reimplementation
    [dzcpu_ucode_lut.v]
2016-04-05 fix: dev: Fixed BC write to Flops
    [dzcpu.v]
2016-04-05 fix: dev: Ammended error from previous commit
    [dzcpu.v]
2016-04-06 fix: dev: added NOP to bz80op for flags_eof bug
    [dzcpu.v, dzcpu_ucode_lut.v]
2016-04-06 chg: dev: Added option to stop after first unkown flow
2016-04-08 fix: dev: Fix INCBC
    [dzcpu_ucode_lut.v]
2016-04-09 fix: dev: Fixed anda uop
    [dzcpu_ucode_lut.v, tb_simple_dzcpu.v, z80_opcode_definitions.v]
2016-04-09 fix: dev: Fixed LDAmm
    [dzcpu_ucode_lut.v]
2016-04-10 fix: dev: Fixed several flag_update related instructions `DECDE `DECr_h `DECHL `INCr_a `INCSP `DECSP `INCr_l `DECr_l
    [dzcpu_ucode_lut.v, tb_simple_dzcpu.v]
2016-04-10 fix: dev: Fixed INCr_h
    [dzcpu_ucode_lut.v, tb_simple_dzcpu.v]
2016-04-16 fix: dev: Added xora to TB
    [tb_simple_dzcpu.v]
2016-04-17 fix: dev: Fixed incorrect printing
    [tb_simple_dzcpu.v]
2016-04-18 fix: dev: Fixed addx16r16
    [tb_simple_dzcpu.v, z80_opcode_definitions.v]
2016-04-20 fix: dev: Fixed RETNC wrong uOp
    [dzcpu_ucode_lut.v]
2016-04-24 chg: dev: temp initial values for tests with Gearboy @wip
2016-04-24 fix: dev: fixed update flags
    [dzcpu.v]
2016-04-25 fix: dev: Fixed Half carry behavior
    [dzcpu.v]
2016-05-03 chg: dev: Updated CPU to support y8, and xy16 registers, fixed flags for various operations
    [dzcpu.v, dzcpu_ucode_lut.v, z80_opcode_definitions.v]
2016-05-03 chg: dev: Added option for GearBoy trace file
2016-05-06 @chg@dev added sprite offset logic for cases were sprite doesnt fit entirely over current tile
2016-05-07 @chg@dev fixed lcdc condition for sprites. Bit 1 has to be on for sprites to be on, unlike previously which was set as bit 2, ucode line 16 and 17 were the ones changed. Compilation line has to be ch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
    [gpu_ucode_rom.v]
2016-05-07 @cosmetic@dev removed unused wires
2016-05-11 chg: dev: Replaced tabs for spaces @cosmetic
    [tb_simple_dzcpu.v]
2016-05-12 fix: dev: Fixed error with ADD hafl carry
    [dzcpu.v]
2016-05-13 fix: dev: comment ORn instruction
    [tb_simple_dzcpu.v]
2016-05-23 fix: dev: Fixed ADDr_h and ADDr_l
    [dzcpu.v]
2016-05-23 fix: dev: Fixed AND behavior for tests
    [dzcpu.v]
2016-05-25 fix: dev: fix opcode of LDHLmr_h instruction
    [z80_opcode_definitions.v]
2016-05-25 fix: dev: fix LDrHLm_e instruction
    [dzcpu_ucode_lut.v]
2016-05-25 fix: dev: Fixwed incorrect include file name @wip
    [io.v]
2016-05-26 fix: dev: Fixed carry for ADDn
    [dzcpu.v, dzcpu_ucode_lut.v, z80_opcode_definitions.v]
2016-05-30 fix: dev: Change opcode of LDrr_ch and LDrr_cl
    [z80_opcode_definitions.v]
2016-05-30 fix: dev: fix opcode LDrr_de
    [z80_opcode_definitions.v]
2016-05-31 fix: dev: LDrr instructions is not be implemented in LUT, special tb
    [tb_simple_dzcpu.v]
2016-05-31 fix: dev: LDrr instructions is no necesary in dzcpu_LUT. intsructios be implement in dzcpu.v
    [dzcpu_ucode_lut.v]
2016-06-01 chg: Fixed Y8 register
    [dzcpu.v, dzcpu_ucode_lut.v]
2016-06-01 fix: dev: I hate git
    [gpu.v, gpu_ucode_rom.v]
2016-06-02 fix: dev: Fixed ADDr_xx instructions
    [dzcpu_ucode_lut.v]
2016-06-03 chg: dev: Added functionality for Window, fixed LCDC bits @wip
    [gpu.v, gpu_definitions.v, gpu_ucode_rom.v, tb_simple_dzcpu.v]
2016-06-04 fix: dev: Fixed rotate CB instructions
    [dzcpu_ucode_lut.v]
2016-06-04 fix: dev: Fixed flags for SUBr_b test
    [dzcpu.v]
2016-06-05 fix: dev: fixed CPn flags
    [dzcpu.v]
2016-06-05 fix: dev: Fixed incorrect flags in SHL
    [dzcpu.v]
2016-06-05 fix: dev: Fixed XORn
    [dzcpu.v]
2016-06-05 @dev window logic almost done, some bug present, window is loading from bottom half of it
    [gpu.v, gpu_definitions.v, gpu_ucode_rom.v]
2016-06-05 fix: dev: Fixed RR instruction flags
    [dzcpu.v, z80_opcode_definitions.v]
2016-06-06 fix: dev: fixed RRr_a
    [dzcpu.v, dzcpu_ucode_lut.v]
2016-06-06 fix: dev: fixed JRNCn
    [dzcpu.v, dzcpu_ucode_lut.v, z80_opcode_definitions.v]
2016-06-07 fix: dev: Fixed ADDn
    [dzcpu.v, dzcpu_ucode_lut.v]
2016-06-18 fix: dev: fixed CPn
    [dzcpu.v, mmu.v]
2016-06-18 fix: dev: Fixed PUSHAF
    [dzcpu.v, z80_opcode_definitions.v]
2016-06-21 fix: dev: Fixed ANDn
    [dzcpu.v]
2016-06-28 fix: dev: Fixed ADC instruction,add new opcode
    [dzcpu.v, dzcpu_ucode_lut.v, tb_simple_dzcpu.v, z80_opcode_definitions.v]
2016-06-28 fix: dev: Fixed RETNz and RETC flows
    [dzcpu_ucode_lut.v]
2016-06-29 fix: dev: Fixed flagd for ORHL
    [dzcpu.v]
2016-06-29 fix: dev: Fixed DECHLm
    [dzcpu.v]
2016-06-29 chg: dev: Fixed 16bit carry
    [dzcpu.v]
2016-07-03 fix: dev: Fixed JPHL:
    [dzcpu_ucode_lut.v, tb_simple_dzcpu.v]
2016-07-04 fix: dev: Prevent PC from getting overwritten unless flow is enabled
    [dzcpu.v]
2016-07-04 fix: dev: Fixed EI and JPNZnn
    [dzcpu_ucode_lut.v, tb_simple_dzcpu.v]
2016-07-04 fix: dev: Fixed ADCn
    [dzcpu.v]
2016-07-06 chg: dev: Updated UCODE ROM to support up to 1024 flows
2016-07-06 fix: dev: Fixed LDHLSPn
    [dzcpu_ucode_lut.v, tb_simple_dzcpu.v, z80_opcode_definitions.v]
2016-07-06 fix: dev: Fixed LDHLSPn flag update
    [dzcpu.v, dzcpu_ucode_lut.v]
2016-07-12 new: dev: Added first non working version of timers @wip
2016-07-16 chg: dev: Added timer instance
2016-07-18 chg: dev: Added Timer hierarchy to waveform
2016-07-18 fix: dev: Fixed second mux selector bits
    [timers.v]
2016-07-18 fix: Added timming for CB instructions:
    [dzcpu.v, timers.v]
2016-07-18 chg: dev: Added option to override timer initial value
2016-07-19 chg: dev: Added LUT for branch timers
2016-07-20 fix: dev: Added branch timming
    [dzcpu.v, timers.v]
2016-07-20 fix: dev: Fixed trace so it does not depend on cpu log
    [tb_simple_dzcpu.v]
2016-07-20 chg: dev: Added timer signals
2016-07-22 fix: dev: Fixed branch taken timer LUT (but screwed up extended)
    [dzcpu.v, tb_simple_dzcpu.v, timers.v]
2016-07-25 new: dev: Added dzcpu flow nemonics
2016-07-25 new: dev: Added timer FSM signals
2016-07-25 chg: dev: Fixed timer to reflect true gameboy timmings
    [dzcpu.v, timers.v]
2016-07-29 fix: dev: Fixed latest START_DUMP_INSN flag
    [tb_simple_dzcpu.v]
2016-07-29 fix: dev: More accurate div calculation
    [timers.v]
2016-08-02 fix: dev: Fixed IE CPU write in MMU
    [mmu.v, tb_simple_dzcpu.v]
2016-08-05 chg: dev: Refactored TIMER out of the CPU unit
2016-08-05 chg: dev: Updated signals for TIMER
2016-08-05 fix: dev: Fixed TAC write from MMU
    [mmu.v, pGB.v, timers.v]
2016-08-09 chg: dev: Refactored Added interrupt module
2016-08-09 chg: dev: Added interrupt signals
2016-08-09 fix: dev: Fixed FFINT initial value
    [dzcpu.v]
2016-08-10 fix: Added interrupt flow
    [tb_simple_dzcpu.v]
2016-08-10 chg: dev: Added interrupt flow dispatch
2016-08-10 chg: dev: Fixed interrupt dispatch flow
    [dzcpu.v, dzcpu_ucode_lut.v, z80_opcode_definitions.v]
2016-08-14 chg: dev: Added interrupts signals
2016-08-14 fix: dev: fixed missing NOP after sma in LDIOn* flows
    [dzcpu_ucode_lut.v]
2016-08-14 fix: dev: Updated flow id for LDIOn flows
    [tb_simple_dzcpu.v]
2016-08-15 fix: dev: Fixed instruction executed twice before interrupt
    [dzcpu.v, tb_simple_dzcpu.v]
2016-09-04 fix: dev: Resized driver wDivOverflow
    [timers.v]
2016-09-05 fix: dev: Fixed up logic to increment driver oDiv
    [timers.v]
2016-09-06 chg: dev: Updated timer DELTA for interrupt signals
2016-09-06 chg: dev: Added additional tests for interrupts
2016-09-08 fix: dev: Fixed up timer DELTA for interrupt signals
    [timers.v]
2016-09-08 chg: dev: Updated trace of delta TIMER signal
2016-09-13 fix: dev: Changed condition for attend an interrupt
    [dzcpu.v]
2016-09-14 chg: dev: Added trace of JPZnn instruction
2016-09-21 chg: dev: Changed enable for Interrupt Flag register
2016-09-21 chg: dev: Added timer interrupts to interrupt requests
2016-10-05 chg: dev: Renamed int_flags to avoid confusion
    [z80_opcode_definitions.v]
2016-10-05 new: dev: Added hlt microintruction to FlowEnable
2016-10-11 new: dev: Added trace of RET C instruction
2016-10-12 new: dev: Added trace of JPCnn instruction
2016-10-25 new: dev: Defined FSM to reset wDivAux
    [timers.v]
2016-10-25 new: dev: Defined counters in case a HALT occurs
2016-10-25 new: dev: Applied new conditions in case a HALT occurs
2016-11-09 fix: dev: Getting rid of unused define with no macro body
    [z80_opcode_definitions.v]
2016-11-12 fix: dev: Fixed up RETNZ instruction's microflow
    [dzcpu_ucode_lut.v]
2016-11-12 fix: dev: Fixed up trace of JPCnn instruction
    [tb_simple_dzcpu.v]
2016-11-23 new: dev: Added trace of RETI instruction
2016-11-23 chg: dev: Added flag PRINT_STACK
2016-11-23 fix: dev: Fixed up DISPATCH INTERRUPT microflow
    [dzcpu_ucode_lut.v]
2017-05-06 fix: dev: Implemented shl8 ucode
    [dzcpu.v, z80_opcode_definitions.v]
2017-05-06 fix: dev: Implemented addx16c_ext ucode
    [dzcpu.v, z80_opcode_definitions.v]
2017-05-06 fix: dev: Implemented RLCA instruction
    [dzcpu.v, dzcpu_ucode_lut.v, tb_simple_dzcpu.v, z80_opcode_definitions.v]
2017-05-30 chg:dev: Fix ORHL ucode
    [dzcpu_ucode_lut.v]
2017-06-05 fix: dev: Added option to trigger joypad after n instructions
    [tb_simple_dzcpu.v]
2017-06-10 fix: dev: Added flag logic for ORn
    [dzcpu.v]
2017-06-11 fix: dev: Added logic to press key
    [io.v, tb_simple_dzcpu.v]
