diegovalverde/papiGB/(notices)

Notices in the files:
rtl/bios.v:
modify it under the terms of the GNU General Public License
